yatin145/IoT-Based-Vaccine-smart-monitoring-system/README.md

# IoT-Based-Vaccine-smart-monitoring-system
IoT-based vaccine cold-chain monitoring system using ESP32, DS18B20, SIM900A, R307 fingerprint sensor, and OV2640 camera for real-time temperature tracking, biometric access control, SMS/call alerts, Telegram photo updates, WiFi-based location tracking, and cloud analytics via Google Sheets and Power BI.
